npisenti/piezo/calc/AD5663RVoltNoise.png

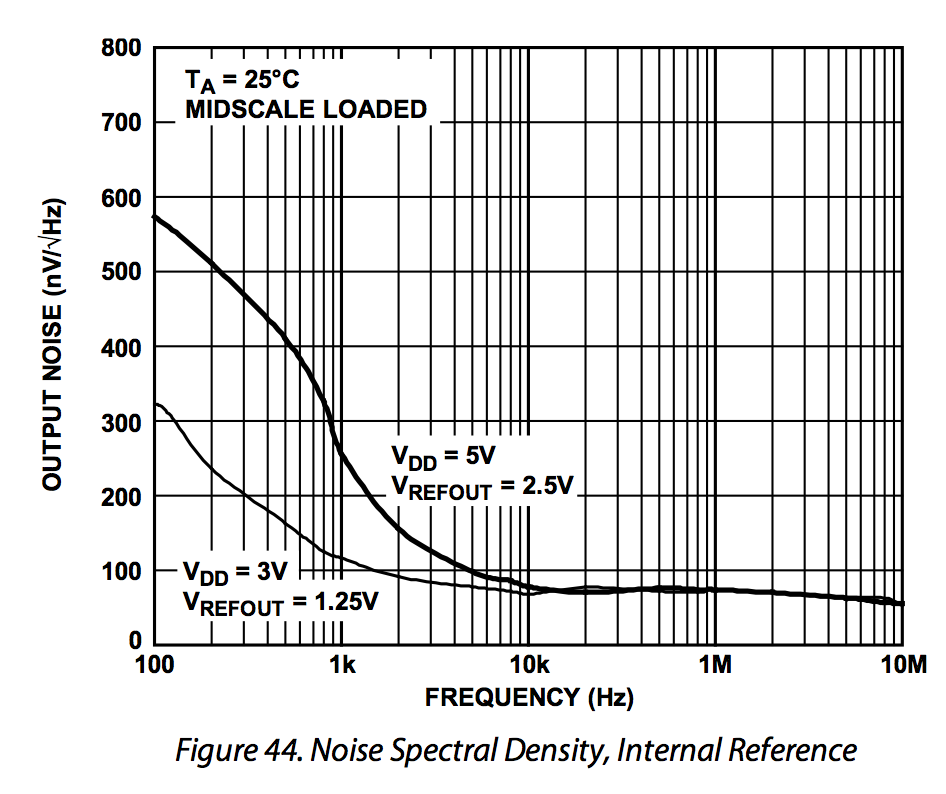
calc/AD5663RVoltNoise.png
