npisenti/piezo/calc/DRVResidualNoise.png

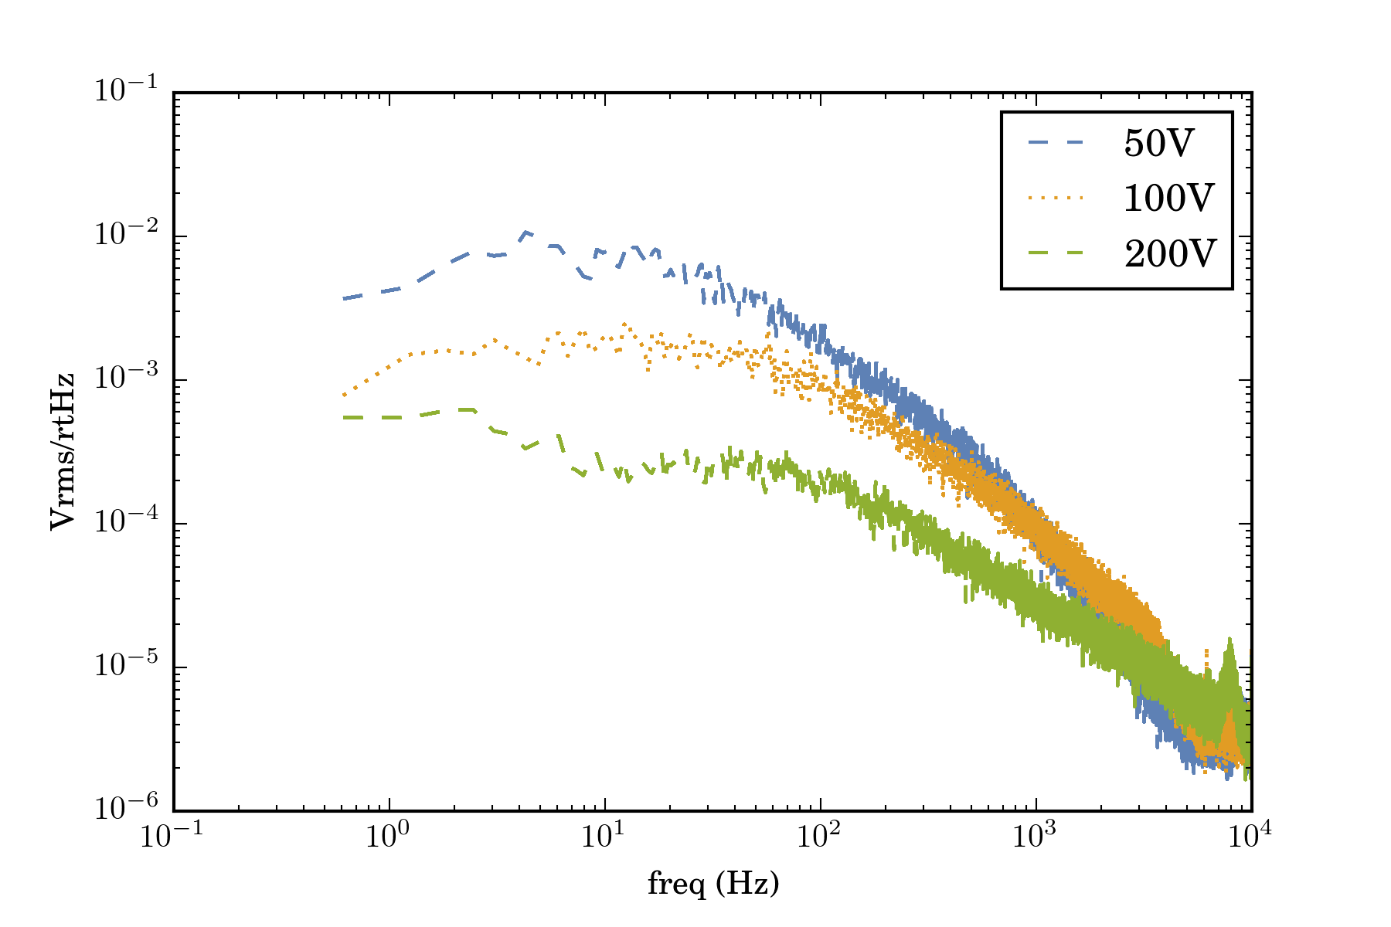
calc/DRVResidualNoise.png
