npisenti/piezo/calc/LM7171CurrNoise.png

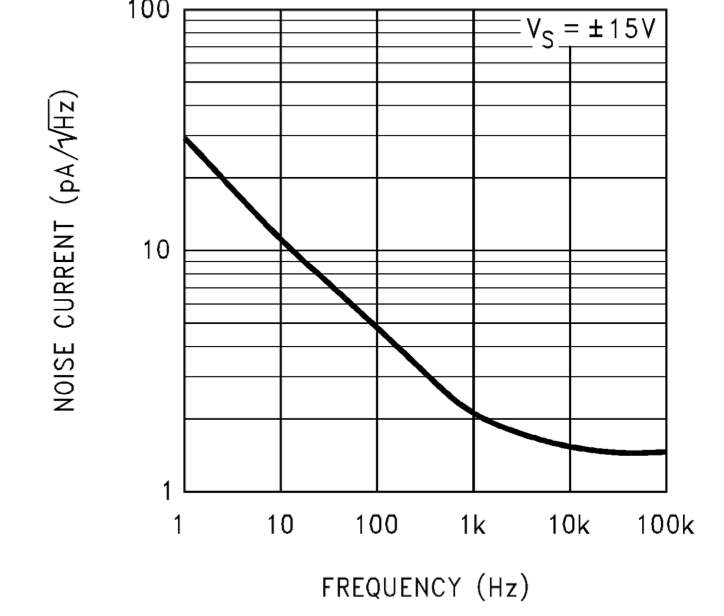
calc/LM7171CurrNoise.png
