npisenti/piezo/calc/LM7171VoltNoise.png

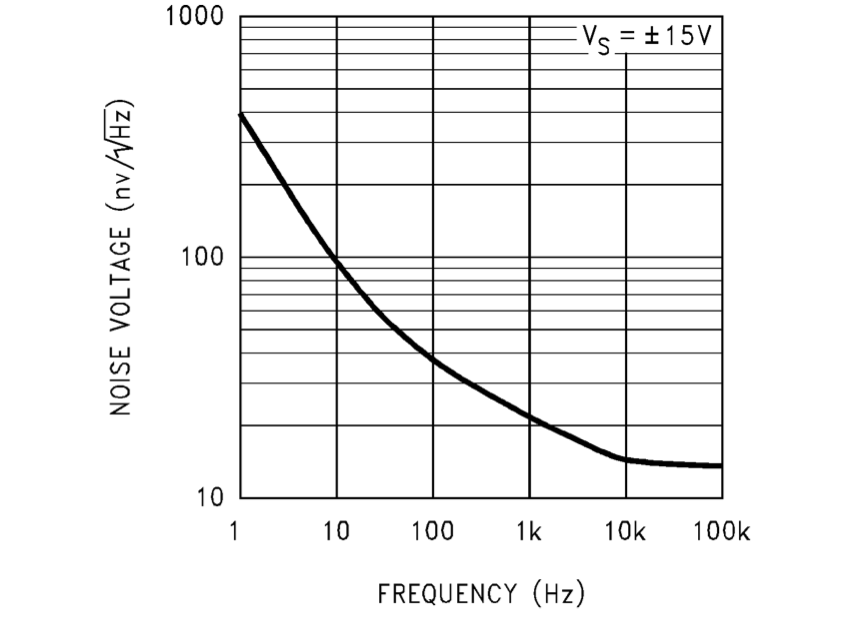
calc/LM7171VoltNoise.png
