npisenti/piezo/(commit log)

2015-12-16 Added some notes about directory structure
    * Link to piezo gerbers & eagle design files
2015-12-19 Sketch of intro done
    * HV stabilization schematic figure
2015-12-23 Added mostly completed schematic; beginning of description of circuit
2015-12-26 Circuit design intro; sketch of design subsections
2016-01-02 Minor sentence tweaks; updated schematic with component names.
2016-01-25 changes up through flyback circuit; notes on what to measure
2016-01-25 Added details to low-noise stabilization section
    Discussion of resistor 1/f noise
2016-01-26 Reworked intro to circuit description
    * Repartitioned "intro" and flyback regulator section; other mods
2016-05-31 Formatting changes; added LP filter switch to schematic
2016-06-22 Round two edits pre second paper torture
    * better overview
    * section about MOS quench and slow ramps
    ** Need to ammend section on voltage monitor
2016-07-31 Added all calculations; hopefully final draft
    * Cleaned up calculation/figure scripts, added raw data, etc.
    * updated .gitignore for temp files
    * exported references.bib such that it only contains relevant entries
    [100V_FFT_01.csv, 100V_FFT_02.csv, 100V_FFT_03.csv, 100V_FFT_04.csv, 100V_FFT_05.csv, 100V_FFT_06.csv, 100V_FFT_07.csv, 100V_FFT_08.csv]
